rglenn/ottawa-badges-2018/README.md

# ottawa-badges-2018
Maker badges for Maker Faire Ottawa 2018

More information is available on the [wiki](https://github.com/rglenn/ottawa-badges-2018/wiki) - please check there!
