rglenn/ottawa-badges-2018/artwork/maple-leaf.bmp

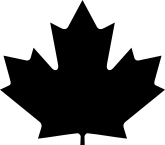
artwork/maple-leaf.bmp
