rglenn/ottawa-badges-2018/Parts for MFOTT badge 2018.docx

# Parts for Maker Faire Ottawa badge 2018

DO NOT MOUNT: C2,C5,R18,R19

0603 Red LED x 41
D1-D41

0603 56 ohm resistor x 10
R1,R2,R3,R4,R5,R6,R7,R9,R10,R16

0603 1K resistor x 4 0603 100n capacitor x 4 0603 220 ohm resistor x 2
R11,R12,R13,R17 C1,C4,C6,C10 R20,R21

0603 10K resistor x 2 0603 1u capacitor x 2 0603 1.5K resistor x 1
R14,R15 C7,C8 R8

0805 10u capacitor x 1 0805 IR LED x 1 MIC5504 voltage regulator x 1
C9 D42 U2

USB connector x 1 ATMega328PB x 1 12 MHz crystal x 1
P1 U1 Y1

Piezo speaker x 1 VS1838B IR receiver x 1
