rglenn/ottawa-badges-2018/pcb/ottawa-badges-2016_bom.xlsx

Source | C:/Projects/ottawa-badges-2016/pcb/ottawa-badges-2016.sch
Kicad Rev | Eeschema 4.0.0-rc1-stable
Generated Date | 2016-11-16 21:01
Title | Not Set
Company | Not Set
Revision | Not Set
Date Issue | Not Set
Reference | Value | Library | Library Ref
U1 | ATMEGA328P-A | BadgeParts | ATMEGA328PB-A
P1 | USB_OTG | conn | USB_OTG
Y1 | 12 MHz | device | Crystal_Small
D3 | Led_Small | device | Led_Small
D4 | Led_Small | device | Led_Small
D5 | Led_Small | device | Led_Small
D6 | Led_Small | device | Led_Small
D2 | Led_Small | device | Led_Small
D1 | Led_Small | device | Led_Small
D9 | Led_Small | device | Led_Small
D10 | Led_Small | device | Led_Small
D11 | Led_Small | device | Led_Small
D12 | Led_Small | device | Led_Small
D8 | Led_Small | device | Led_Small
D7 | Led_Small | device | Led_Small
D15 | Led_Small | device | Led_Small
D16 | Led_Small | device | Led_Small
D17 | Led_Small | device | Led_Small
D18 | Led_Small | device | Led_Small
D14 | Led_Small | device | Led_Small
D13 | Led_Small | device | Led_Small
D21 | Led_Small | device | Led_Small
D22 | Led_Small | device | Led_Small
D23 | Led_Small | device | Led_Small
D24 | Led_Small | device | Led_Small
D20 | Led_Small | device | Led_Small
D19 | Led_Small | device | Led_Small
D27 | Led_Small | device | Led_Small
D28 | Led_Small | device | Led_Small
D29 | Led_Small | device | Led_Small
D30 | Led_Small | device | Led_Small
D26 | Led_Small | device | Led_Small
D25 | Led_Small | device | Led_Small
D33 | Led_Small | device | Led_Small
D34 | Led_Small | device | Led_Small
D35 | Led_Small | device | Led_Small
D36 | Led_Small | device | Led_Small
D32 | Led_Small | device | Led_Small
D31 | Led_Small | device | Led_Small
D39 | Led_Small | device | Led_Small
D40 | Led_Small | device | Led_Small
D38 | Led_Small | device | Led_Small
D37 | Led_Small | device | Led_Small
R1 | 56 | device | R
R2 | 56 | device | R
R3 | 56 | device | R
R4 | 56 | device | R
R5 | 56 | device | R
R6 | 56 | device | R
R7 | 56 | device | R
C5 | 18p | device | C
C2 | 18p | device | C
C4 | 100n | device | C
C6 | 100n | device | C
C1 | 100n | device | C
R10 | 56 | device | R
R9 | 56 | device | R
R8 | 1.5K | device | R
JP1 | Jumper_NC_Small | device | Jumper_NC_Small
JP2 | Jumper_NC_Small | device | Jumper_NC_Small
JP3 | Jumper_NC_Small | device | Jumper_NC_Small
JP4 | Jumper_NC_Small | device | Jumper_NC_Small
JP6 | Jumper_NC_Small | device | Jumper_NC_Small
JP5 | Jumper_NC_Small | device | Jumper_NC_Small
JP7 | Jumper_NC_Small | device | Jumper_NC_Small
U2 | MIC5504-3.3YM5 | regul | LT1761
SW1 | SWITCH_INV | device | SWITCH_INV
C7 | 1u | device | C
C8 | 1u | device | C
BT1 | CR2032 | device | Battery
R12 | 1K | device | R
JP9 | Jumper_NC_Small | device | Jumper_NC_Small
D41 | Led_Small | device | Led_Small
SP1 | SPEAKER | device | SPEAKER
R11 | 1K | device | R
JP8 | Jumper_NC_Small | device | Jumper_NC_Small
R13 | 1K | device | R
JP10 | Jumper_NC_Small | device | Jumper_NC_Small
D42 | Led_Small | device | Led_Small
R14 | 10K | device | R
P4 | CONN_01X10 | conn | CONN_01X10
P5 | CONN_01X08 | conn | CONN_01X08
P2 | CONN_01X08 | conn | CONN_01X08
P3 | CONN_01X06 | conn | CONN_01X06
P6 | CONN_02X03 | conn | CONN_02X03
P7 | CONN_01X01 | conn | CONN_01X01
P8 | CONN_01X01 | conn | CONN_01X01
P10 | CONN_01X01 | conn | CONN_01X01
U3 | VS1838B | BadgeParts | VS1838B
JP11 | Jumper_NC_Small | device | Jumper_NC_Small
R17 | 1K | device | R
R15 | 10K | device | R
C10 | 100n | device | C
R16 | 56 | device | R
C9 | 10u | device | C
P9 | CONN_01X04 | conn | CONN_01X04
