rglenn/ottawa-badges-2018/pcb/ottawa-badges-2016_bom_chipsetter.xlsx

Part | Value | Device | Package | Description
C1 | 100n | C | C_0603
C10 | 100n | C | C_0603
C101 | 100n | C | C_0603
C102 | 18p | C | C_0603
C104 | 100n | C | C_0603
C105 | 18p | C | C_0603
C106 | 100n | C | C_0603
C107 | 1u | C | C_0603
C108 | 1u | C | C_0603
C109 | 10u | C | C_0805
C110 | 100n | C | C_0603
C2 | 18p | C | C_0603
C4 | 100n | C | C_0603
C5 | 18p | C | C_0603
C6 | 100n | C | C_0603
C7 | 1u | C | C_0603
C8 | 1u | C | C_0603
C9 | 10u | C | C_0805
D1 | Led_Small | Led_Small | LED_0603
D10 | Led_Small | Led_Small | LED_0603
D101 | Led_Small | Led_Small | LED_0603
D102 | Led_Small | Led_Small | LED_0603
D103 | Led_Small | Led_Small | LED_0603
D104 | Led_Small | Led_Small | LED_0603
D105 | Led_Small | Led_Small | LED_0603
D106 | Led_Small | Led_Small | LED_0603
D107 | Led_Small | Led_Small | LED_0603
D108 | Led_Small | Led_Small | LED_0603
D109 | Led_Small | Led_Small | LED_0603
D11 | Led_Small | Led_Small | LED_0603
D110 | Led_Small | Led_Small | LED_0603
D111 | Led_Small | Led_Small | LED_0603
D112 | Led_Small | Led_Small | LED_0603
D113 | Led_Small | Led_Small | LED_0603
D114 | Led_Small | Led_Small | LED_0603
D115 | Led_Small | Led_Small | LED_0603
D116 | Led_Small | Led_Small | LED_0603
D117 | Led_Small | Led_Small | LED_0603
D118 | Led_Small | Led_Small | LED_0603
D119 | Led_Small | Led_Small | LED_0603
D12 | Led_Small | Led_Small | LED_0603
D120 | Led_Small | Led_Small | LED_0603
D121 | Led_Small | Led_Small | LED_0603
D122 | Led_Small | Led_Small | LED_0603
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
U1 | ATMEGA328P-A | ATMEGA328PB-A | TQFP-32_7x7mm_Pi
U101 | ATMEGA328P-A | ATMEGA328PB-A | TQFP-32_7x7mm_Pi
U102 | MIC5504-3.3YM5 | LT1761 | SOT-23-5
U2 | MIC5504-3.3YM5 | LT1761 | SOT-23-5
Y1 | 12 MHz | Crystal_Small | crystal_FA238-TS
Y101 | 12 MHz | Crystal_Small | crystal_FA238-TS
