rglenn/ottawa-badges-2018/artwork/makey-floating-pcb-outline.dxf

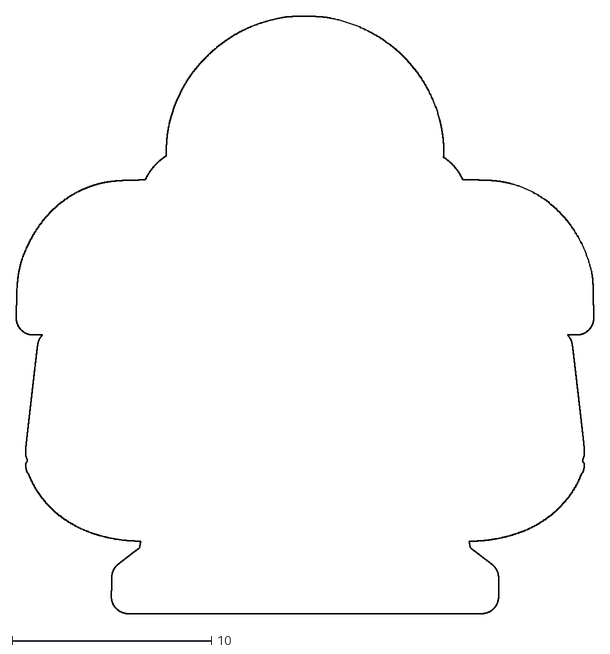
[picture p2: CAD file, 2018-10-16]
artwork/makey-floating-pcb-outline.dxf
29.0 x 30.0
