rglenn/ottawa-badges-2018/artwork/makey-soldering-kit-outline.dxf

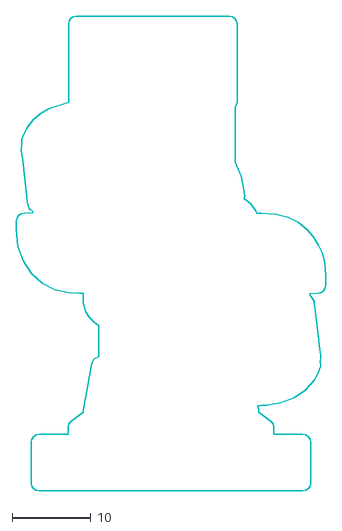
[picture p3: CAD file, 2018-10-16]
artwork/makey-soldering-kit-outline.dxf
39.2 x 60.3
