rglenn/ottawa-badges-2018/artwork/makey-chest-mask.png

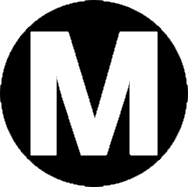
artwork/makey-chest-mask.png
