rglenn/ottawa-badges-2018/artwork/makey-floating-pcb-silk.png

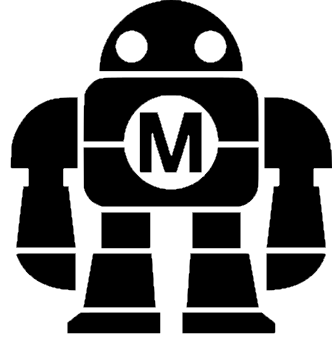
artwork/makey-floating-pcb-silk.png
