rglenn/ottawa-badges-2018/artwork/makey-soldering-kit-silk.png

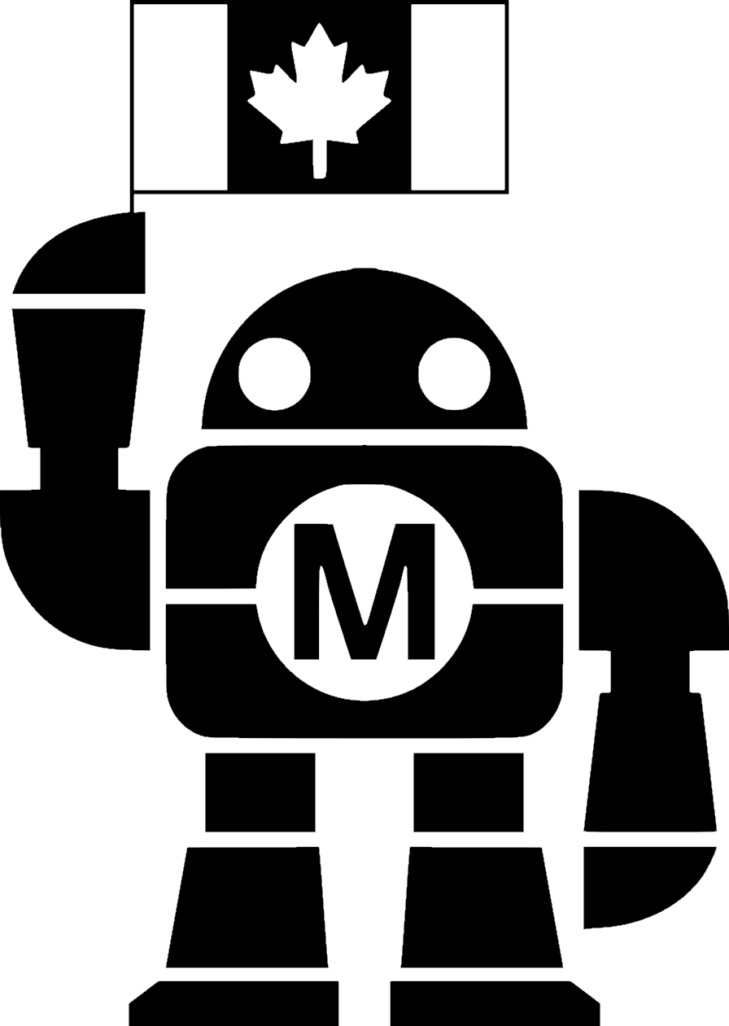
artwork/makey-soldering-kit-silk.png
