rglenn/ottawa-badges-2018/pcb/ottawa-badges-2016.kicad_pcb

## KiCad design pcb/ottawa-badges-2016.kicad_pcb (2018-10-16)

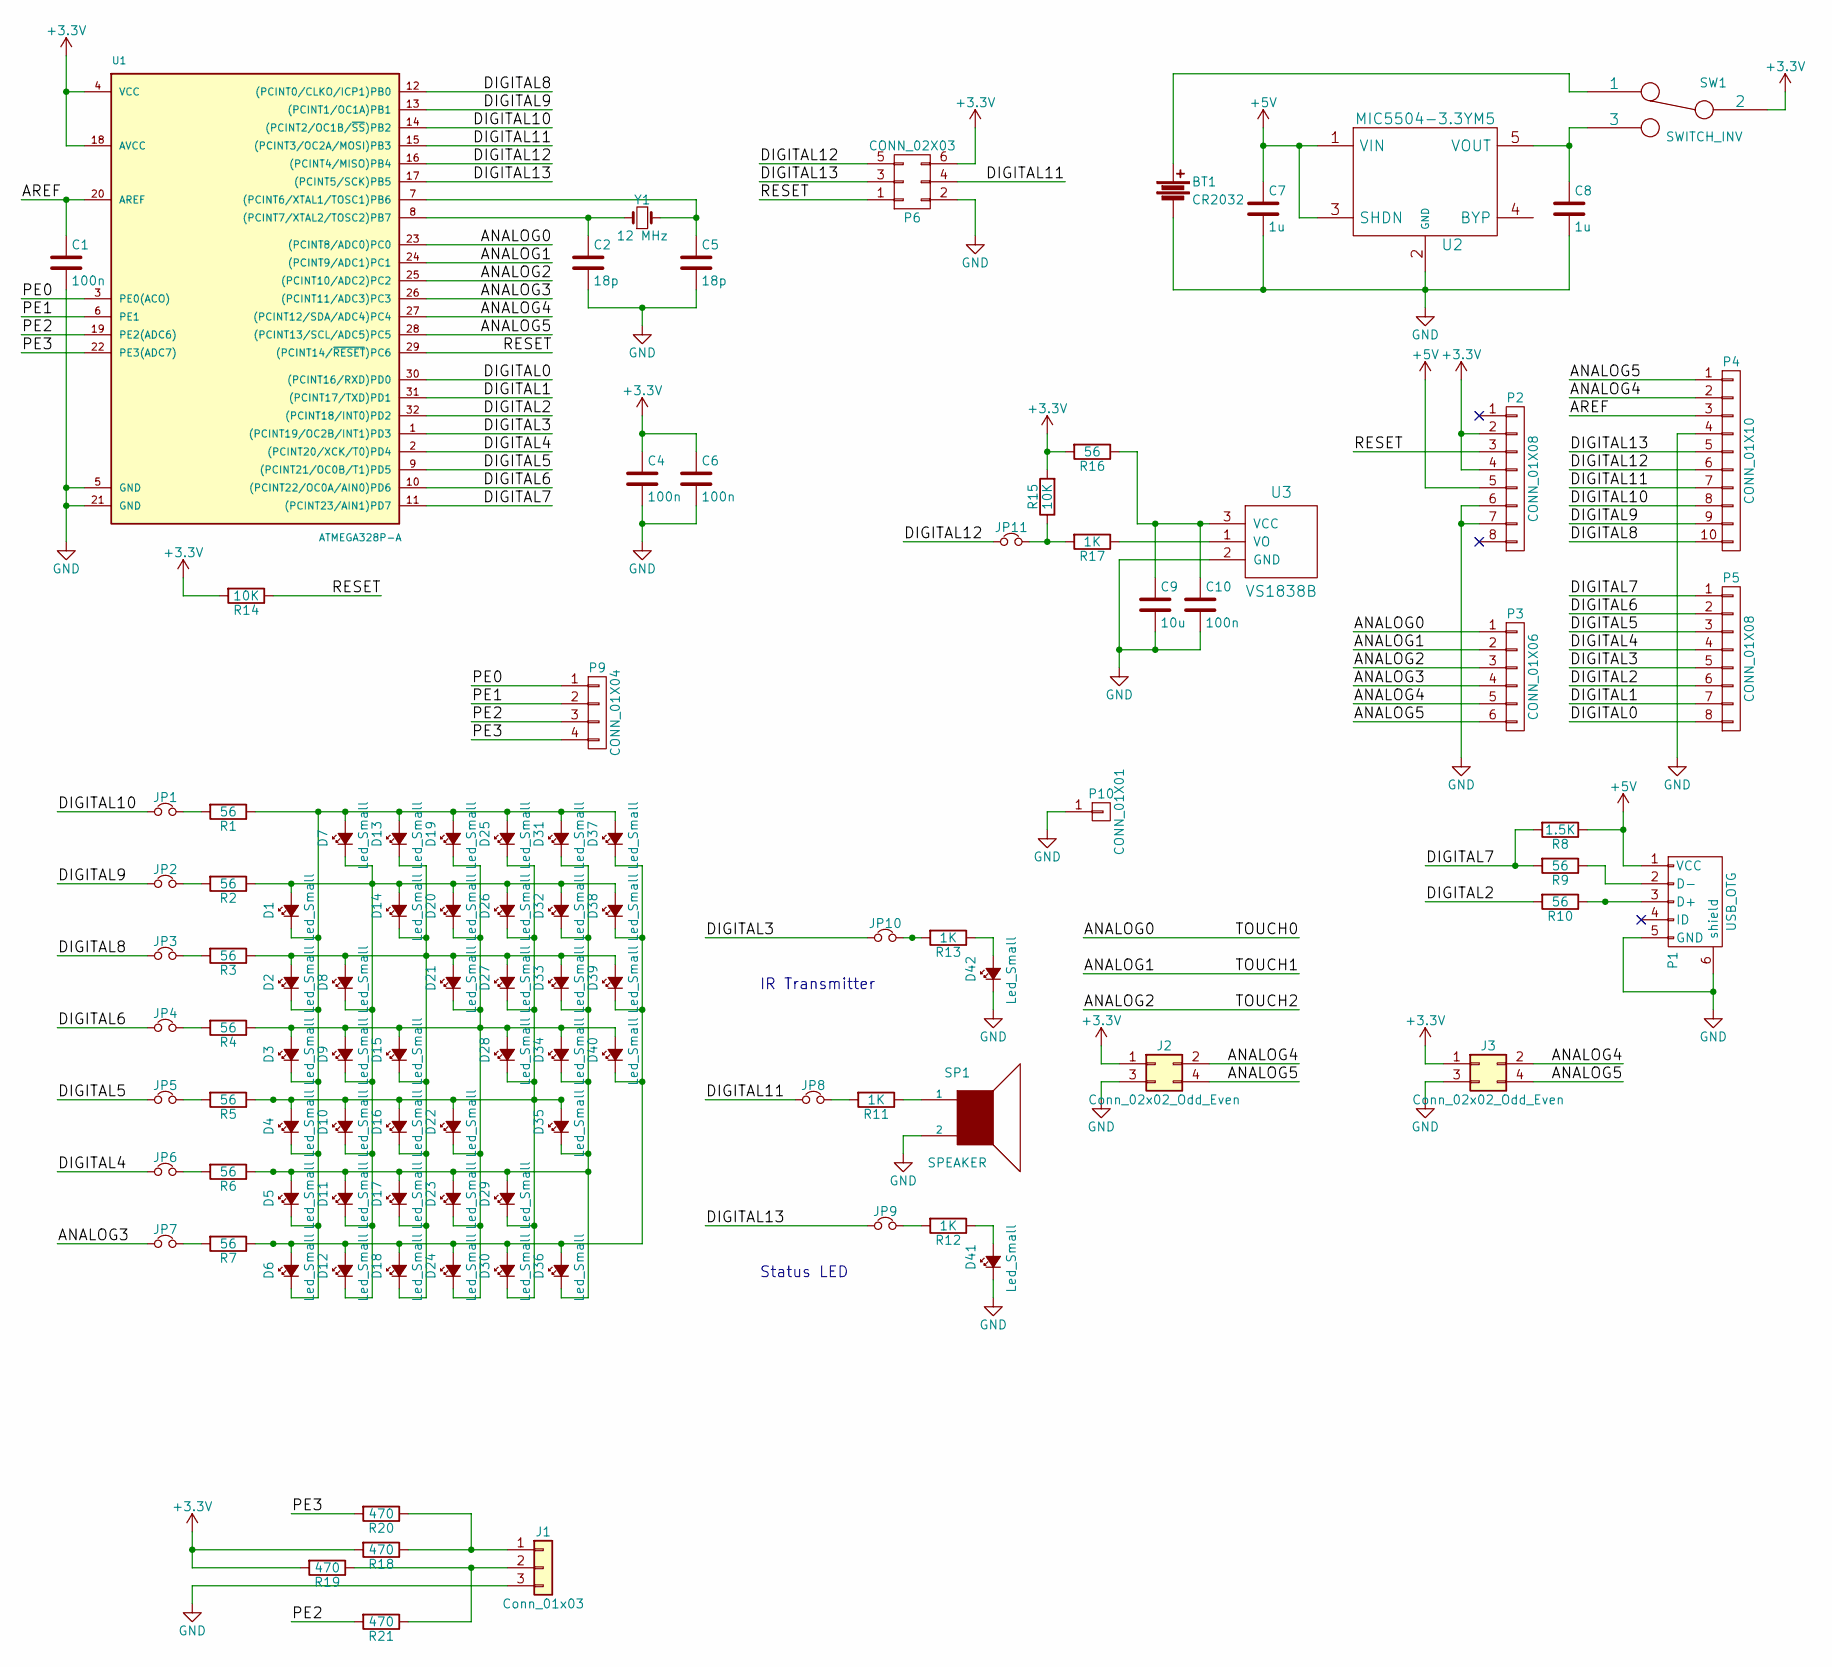
[picture p7: schematic ottawa-badges-2016.sch]

Parts:
BT1: CR2032; CR2032-SHRAPNEL
C1, C4, C6, C10: 100n; C_0603
C2, C5: 18p; C_0603
C7, C8: 1u; C_0603
C9: 10u; C_0805
D1, D2, D3, D4, D5, D6, D7, D8, D9, D10, D11, D12, D13, D14, D15, D16, D17, D18, D19, D20, D21, D22, D23, D24, D25, D26, D27, D28, D29, D30, D31, D32, D33, D34, D35, D36, D37, D38, D39, D40, D41: Led_Small; LED_0603
D42: Led_Small; LED_0805
J1: Conn_01x03; Pin_Header_Straight_1x03_Pitch2.54mm
J2, J3: Conn_02x02_Odd_Even; Pin_Header_Straight_2x02_Pitch2.54mm
JP1, JP2, JP3, JP4, JP5, JP6, JP7, JP8, JP9, JP10, JP11: Jumper_NC_Small; SJ2
P1: USB_OTG; 10118192-0001LF
P2, P5: CONN_01X08; Socket_Strip_Straight_1x08
P3: CONN_01X06; Socket_Strip_Straight_1x06
P4: CONN_01X10; Socket_Strip_Straight_1x10
P6: CONN_02X03; Socket_Strip_Straight_2x03
P9: CONN_01X04; Socket_Strip_Straight_1x04
P10: CONN_01X01; MountingHole_4mm_Pad_Via
R1, R2, R3, R4, R5, R6, R7, R9, R10, R16: 56; R_0603
R8: 1.5K; R_0603
R11, R12, R13, R17: 1K; R_0603
R14, R15: 10K; R_0603
R18, R19, R20, R21: 470; R_0603
SP1: SPEAKER; Buzzer_12x9.5RM7.6
SW1: SWITCH_INV; MK-12C02
U1: ATMEGA328P-A; TQFP-32_7x7mm_Pitch0.8mm
U2: MIC5504-3.3YM5; SOT-23-5
U3: VS1838B; VS1838B-HORIZ
Y1: 12 MHz; crystal_FA238-TSX3225

Connections:
+3V3: C4.1, C6.1, J2.1, J3.1, P2.2, P2.4, P6.6, R14.2, R15.2, R16.2, R18.2, R19.2, SW1.2, U1.4 (VCC), U1.18 (AVCC)
+5V: C7.1, P1.1 (VCC), P2.5, R8.1, U2.1 (VIN), U2.3 (SHDN)
/ANALOG0: P3.1, U1.23 ((PCINT8/ADC0)PC0)
/ANALOG1: P3.2, U1.24 ((PCINT9/ADC1)PC1)
/ANALOG2: P3.3, U1.25 ((PCINT10/ADC2)PC2)
/ANALOG3: JP7.1, P3.4, U1.26 ((PCINT11/ADC3)PC3)
/ANALOG4: J2.2, J3.2, P3.5, P4.2, U1.27 ((PCINT12/SDA/ADC4)PC4)
/ANALOG5: J2.4, J3.4, P3.6, P4.1, U1.28 ((PCINT13/SCL/ADC5)PC5)
/AREF: C1.1, P4.3, U1.20 (AREF)
/DIGITAL0: P5.8, U1.30 ((PCINT16/RXD)PD0)
/DIGITAL1: P5.7, U1.31 ((PCINT17/TXD)PD1)
/DIGITAL2: P5.6, R10.2, U1.32 ((PCINT18/INT0)PD2)
/DIGITAL3: JP10.1, P5.5, U1.1 ((PCINT19/OC2B/INT1)PD3)
/DIGITAL4: JP6.1, P5.4, U1.2 ((PCINT20/XCK/T0)PD4)
/DIGITAL5: JP5.1, P5.3, U1.9 ((PCINT21/OC0B/T1)PD5)
/DIGITAL6: JP4.1, P5.2, U1.10 ((PCINT22/OC0A/AIN0)PD6)
/DIGITAL7: P5.1, R8.2, R9.2, U1.11 ((PCINT23/AIN1)PD7)
/DIGITAL8: JP3.1, P4.10, U1.12 ((PCINT0/CLKO/ICP1)PB0)
/DIGITAL9: JP2.1, P4.9, U1.13 ((PCINT1/OC1A)PB1)
/DIGITAL10: JP1.1, P4.8, U1.14 ((PCINT2/OC1B/~SS~)PB2)
/DIGITAL11: JP8.1, P4.7, P6.4, U1.15 ((PCINT3/OC2A/MOSI)PB3)
/DIGITAL12: JP11.1, P4.6, P6.5, U1.16 ((PCINT4/MISO)PB4)
/DIGITAL13: JP9.1, P4.5, P6.3, U1.17 ((PCINT5/SCK)PB5)
/PE0: P9.1, U1.3 (PE0(ACO))
/PE1: P9.2, U1.6 (PE1)
/PE2: P9.3, R21.2, U1.19 (PE2(ADC6))
/PE3: P9.4, R20.2, U1.22 (PE3(ADC7))
/RESET: P2.3, P6.1, R14.1, U1.29 ((PCINT14/~RESET~)PC6)
GND: BT1.2, C1.2, C2.2, C4.2, C5.2, C6.2, C7.2, C8.2, C9.2, C10.2, D41.1 (K), D42.1 (K), J1.3, J2.3, J3.3, P1.5 (GND), P1.6 (shield), P2.6, P2.7, P4.4, P6.2, P10.1, SP1.2, U1.5 (GND), U1.21 (GND), U2.2 (GND), U3.2 (GND)
unnamed: BT1.1, SW1.1
unnamed: C2.1, U1.8 ((PCINT7/XTAL2/TOSC2)PB7), Y1.1
unnamed: C5.1, U1.7 ((PCINT6/XTAL1/TOSC1)PB6), Y1.2
unnamed: C8.1, SW1.3, U2.5 (VOUT)
unnamed: C9.1, C10.1, R16.1, U3.3 (VCC)
unnamed: D1.1 (K), D2.1 (K), D3.1 (K), D4.1 (K), D5.1 (K), D6.1 (K), D7.2 (A), D13.2 (A), D19.2 (A), D25.2 (A), D31.2 (A), D37.2 (A), R1.1
unnamed: D1.2 (A), D7.1 (K), D8.1 (K), D9.1 (K), D10.1 (K), D11.1 (K), D12.1 (K), D14.2 (A), D20.2 (A), D26.2 (A), D32.2 (A), D38.2 (A), R2.1
unnamed: D4.2 (A), D10.2 (A), D16.2 (A), D22.2 (A), D25.1 (K), D26.1 (K), D27.1 (K), D28.1 (K), D29.1 (K), D30.1 (K), D35.2 (A), R5.1
unnamed: D5.2 (A), D11.2 (A), D17.2 (A), D23.2 (A), D29.2 (A), D31.1 (K), D32.1 (K), D33.1 (K), D34.1 (K), D35.1 (K), D36.1 (K), R6.1
unnamed: D6.2 (A), D12.2 (A), D18.2 (A), D24.2 (A), D30.2 (A), D36.2 (A), D37.1 (K), D38.1 (K), D39.1 (K), D40.1 (K), R7.1
unnamed: D2.2 (A), D8.2 (A), D13.1 (K), D14.1 (K), D15.1 (K), D16.1 (K), D17.1 (K), D18.1 (K), D21.2 (A), D27.2 (A), D33.2 (A), D39.2 (A), R3.1
unnamed: D3.2 (A), D9.2 (A), D15.2 (A), D19.1 (K), D20.1 (K), D21.1 (K), D22.1 (K), D23.1 (K), D24.1 (K), D28.2 (A), D34.2 (A), D40.2 (A), R4.1
unnamed: D41.2 (A), R12.1
unnamed: D42.2 (A), R13.1
unnamed: J1.1, R18.1, R20.1
unnamed: J1.2, R19.1, R21.1
unnamed: JP1.2, R1.2
unnamed: JP2.2, R2.2
unnamed: JP3.2, R3.2
unnamed: JP4.2, R4.2
unnamed: JP5.2, R5.2
unnamed: JP6.2, R6.2
unnamed: JP7.2, R7.2
unnamed: JP8.2, R11.2
unnamed: JP9.2, R12.2
unnamed: JP10.2, R13.2
unnamed: JP11.2, R15.1, R17.2
unnamed: P1.2 (D-), R9.1
unnamed: P1.3 (D+), R10.1
unnamed: R11.1, SP1.1
unnamed: R17.1, U3.1 (VO)

Notes on the sheet:
IR Transmitter
Status LED

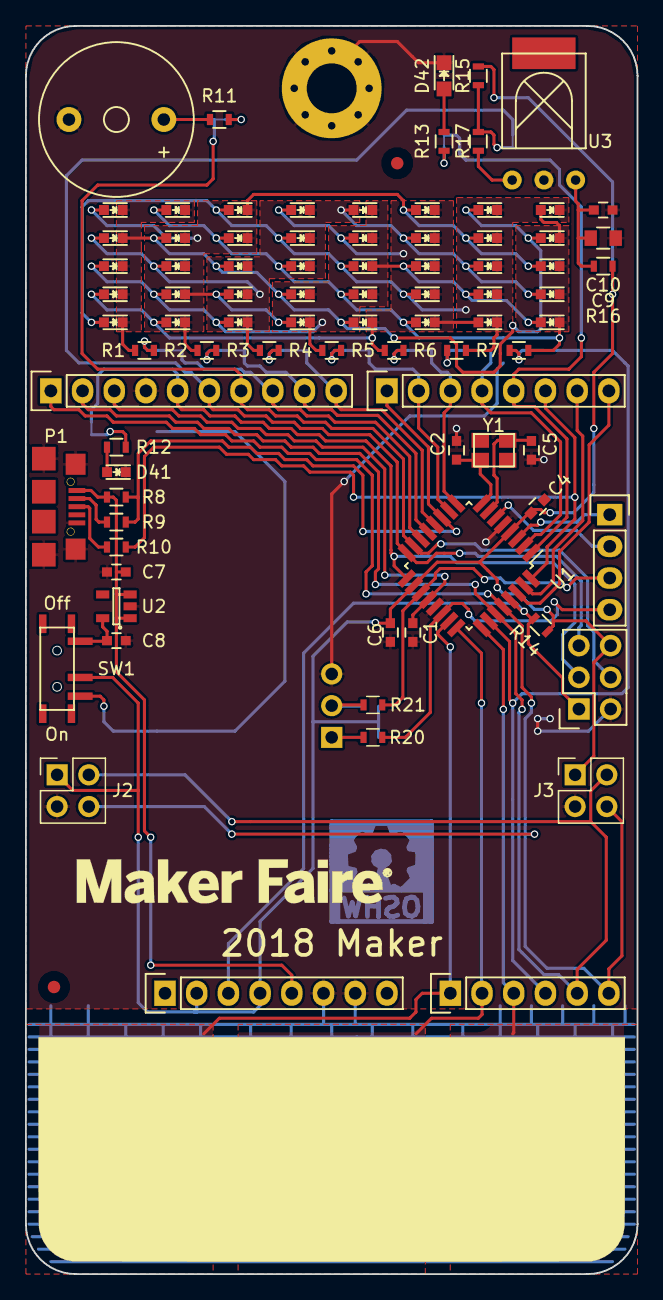
[picture p8: board ottawa-badges-2016.kicad_pcb from above]

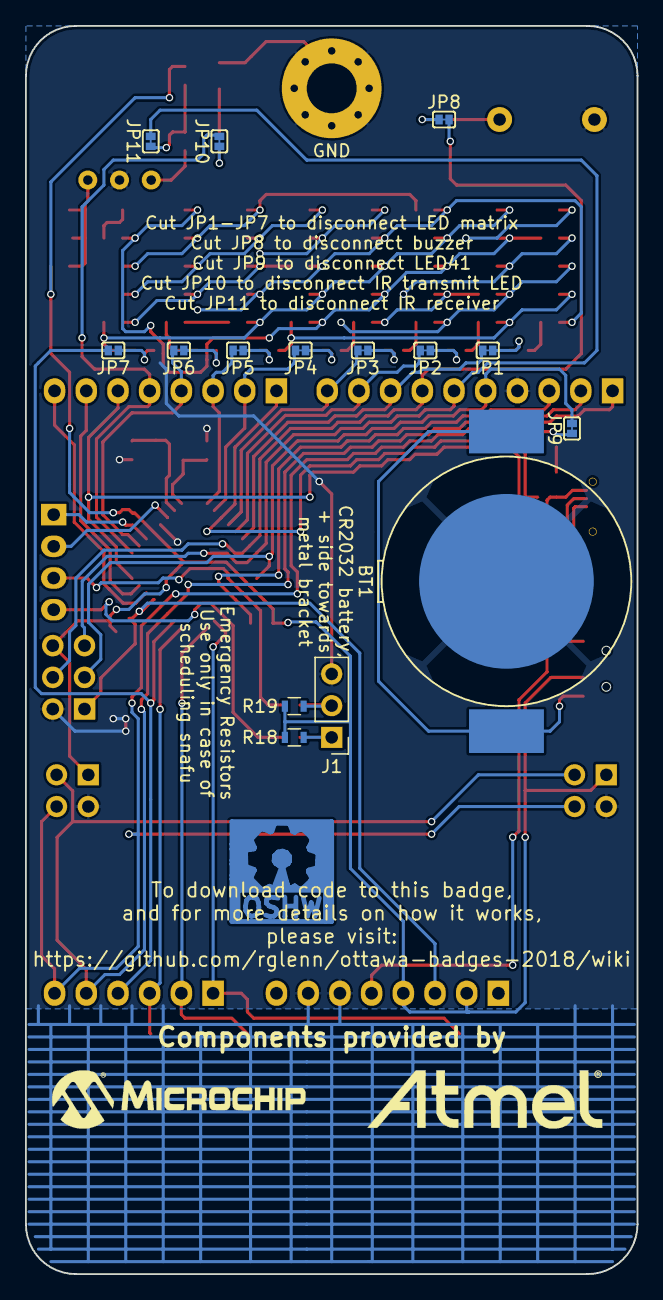
[picture p9: board ottawa-badges-2016.kicad_pcb from below]

Board: 2 copper layers, 49.0 x 100.0 mm, 101 parts (15 on the bottom side), 60 nets.
