rglenn/ottawa-badges-2018/soldering-pcb/soldering-pcb.kicad_pcb

## KiCad design soldering-pcb/soldering-pcb.kicad_pcb (2018-10-16)

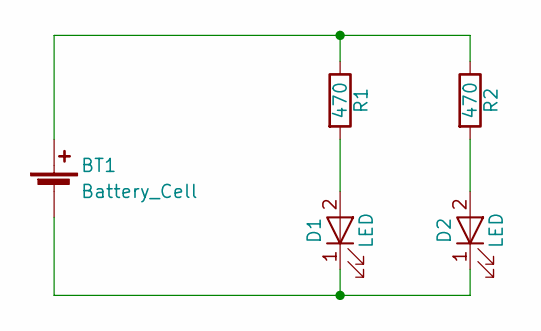
[picture p10: schematic soldering-pcb.sch]

Parts:
BT1: Battery_Cell; CR2032-SHRAPNEL
D1, D2: LED; LED_D5.0mm
R1, R2: 470; R_Axial_DIN0204_L3.6mm_D1.6mm_P7.62mm_Horizontal

Connections:
unnamed: BT1.1 (+), R1.1, R2.1
unnamed: BT1.2 (-), D1.1 (K), D2.1 (K)
unnamed: D1.2 (A), R1.2
unnamed: D2.2 (A), R2.2

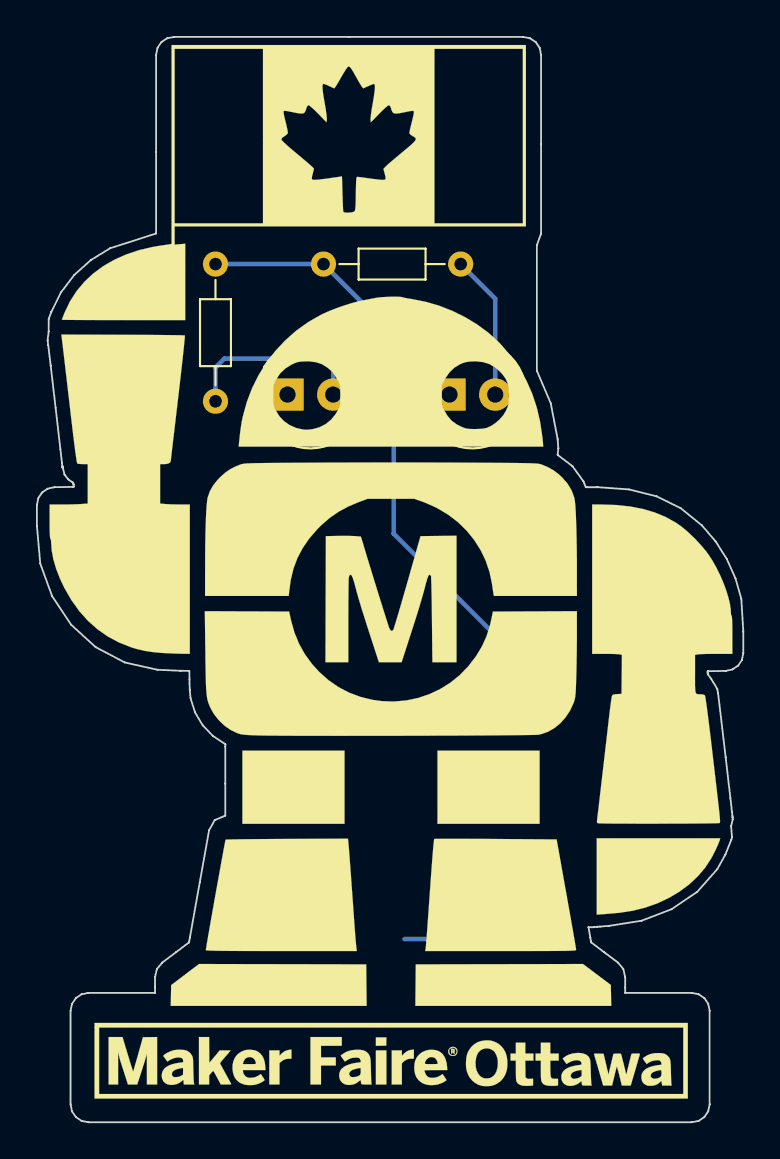
[picture p11: board soldering-pcb.kicad_pcb from above]

Board: 2 copper layers, 39.2 x 60.3 mm, 5 parts (1 on the bottom side), 4 nets.
