rglenn/ottawa-badges-2018/floating-pcb/makey-floating-pcb.kicad_pcb

## KiCad design floating-pcb/makey-floating-pcb.kicad_pcb (2018-10-16)

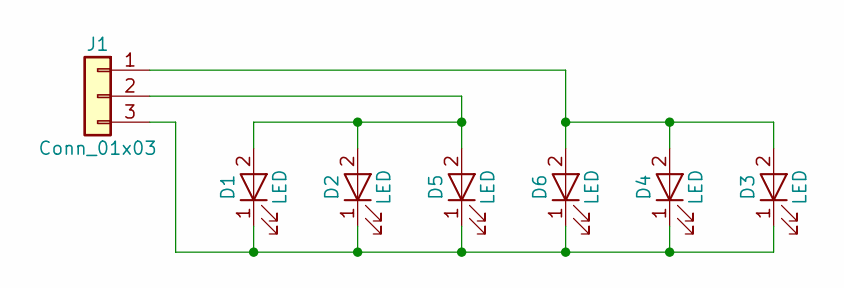
[picture p12: schematic makey-floating-pcb.sch]

Parts:
D1, D2, D3, D4: LED; LED_0603
D5, D6: LED; LED_D3.0mm_Horizontal_O1.27mm_Z2.0mm
J1: Conn_01x03; Pin_Header_Straight_1x03_Pitch2.54mm

Connections:
unnamed: D1.1 (K), D2.1 (K), D3.1 (K), D4.1 (K), D5.1 (K), D6.1 (K), J1.3
unnamed: D1.2 (A), D2.2 (A), D5.2 (A), J1.2
unnamed: D3.2 (A), D4.2 (A), D6.2 (A), J1.1

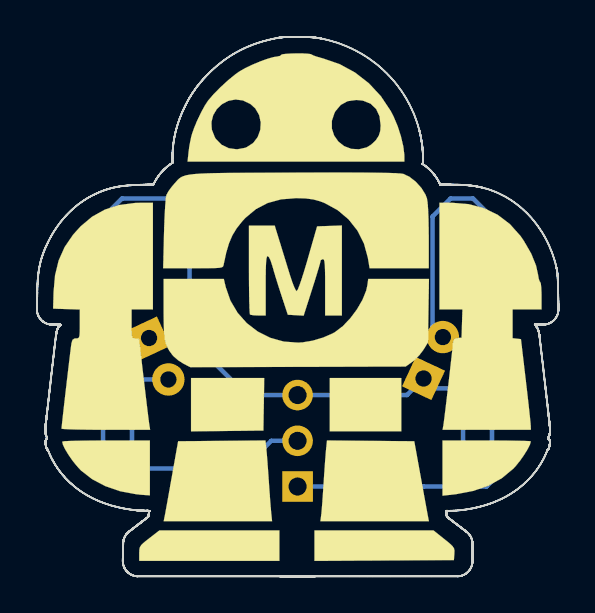
[picture p13: board makey-floating-pcb.kicad_pcb from above]

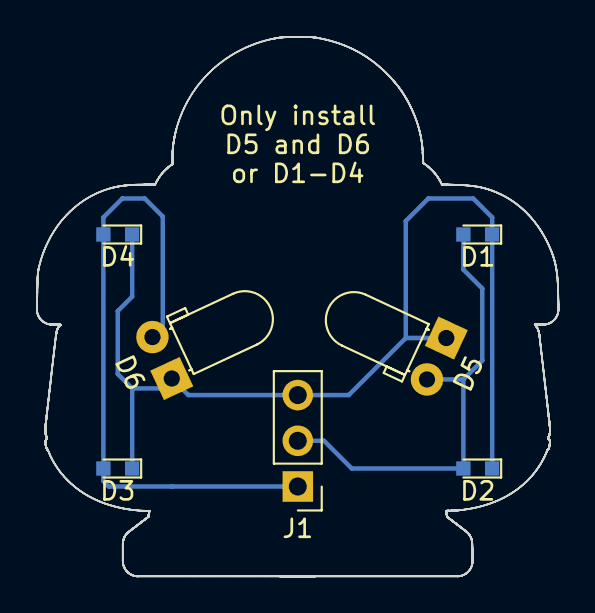
[picture p14: board makey-floating-pcb.kicad_pcb from below]

Board: 2 copper layers, 29.0 x 30.0 mm, 7 parts (7 on the bottom side), 3 nets.
