rglenn/ottawa-badges-2018/code/OttawaBadgeCode2018/animations.h

#pragma once

#include "Arduino.h"

const PROGMEM animationFrame ledWipeDown[] = { 
  {{0xFF, 0x00, 0x00, 0x00, 0x00}, 100}, 
  {{0x00, 0xFF, 0x00, 0x00, 0x00}, 100}, 
  {{0x00, 0x00, 0xFF, 0x00, 0x00}, 100}, 
  {{0x00, 0x00, 0x00, 0xFF, 0x00}, 100}, 
  {{0x00, 0x00, 0x00, 0x00, 0xFF}, 100},
  {{0x00, 0x00, 0x00, 0x00, 0x00}, 100}
}; // 6 frames

const PROGMEM animationFrame ledWipeUp[] = { 
  {{0x00, 0x00, 0x00, 0x00, 0xFF}, 100},
  {{0x00, 0x00, 0x00, 0xFF, 0x00}, 100},
  {{0x00, 0x00, 0xFF, 0x00, 0x00}, 100}, 
  {{0x00, 0xFF, 0x00, 0x00, 0x00}, 100}, 
  {{0xFF, 0x00, 0x00, 0x00, 0x00}, 100},
  {{0x00, 0x00, 0x00, 0x00, 0x00}, 100}
}; // 6 frames

const PROGMEM animationFrame ledWipeLeft[] = { 
  {{0x80, 0x80, 0x80, 0x80, 0x80}, 200},
  {{0xC0, 0xC0, 0xC0, 0xC0, 0xC0}, 200}, 
  {{0x60, 0x60, 0x60, 0x60, 0x60}, 200}, 
  {{0x30, 0x30, 0x30, 0x30, 0x30}, 200}, 
  {{0x18, 0x18, 0x18, 0x18, 0x18}, 200}, 
  {{0x0C, 0x0C, 0x0C, 0x0C, 0x0C}, 200}, 
  {{0x06, 0x06, 0x06, 0x06, 0x06}, 200}, 
  {{0x03, 0x03, 0x03, 0x03, 0x03}, 200}, 
  {{0x01, 0x01, 0x01, 0x01, 0x01}, 200}, 

}; // 9 frames
const PROGMEM animationFrame ledWipeRight[] = { 
  {{0x01, 0x01, 0x01, 0x01, 0x01}, 200}, 
  {{0x03, 0x03, 0x03, 0x03, 0x03}, 200}, 
  {{0x06, 0x06, 0x06, 0x06, 0x06}, 200}, 
  {{0x0C, 0x0C, 0x0C, 0x0C, 0x0C}, 200}, 
  {{0x18, 0x18, 0x18, 0x18, 0x18}, 200}, 
  {{0x30, 0x30, 0x30, 0x30, 0x30}, 200}, 
  {{0x60, 0x60, 0x60, 0x60, 0x60}, 200}, 
  {{0xC0, 0xC0, 0xC0, 0xC0, 0xC0}, 200}, 
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
  {{0xFF, 0x00, 0x00, 0x00, 0x00}, 200}, 
  {{0xFF, 0xFF, 0x00, 0x00, 0x00}, 200}, 
  {{0xFF, 0xFF, 0xFF, 0x00, 0x00}, 200}, 
  {{0xFF, 0xFF, 0xFF, 0xFF, 0x00}, 200}, 
  {{0xFF, 0xFF, 0xFF, 0xFF, 0xFF}, 200}, 
}; // 5 frames

#define EXISTING_MAKER_ANIM_LENGTH 5
