rglenn/ottawa-badges-2018/code/OttawaBadgeCode2018/infrared.cpp

/*
    This file is part of OttawaBadges2015.

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
    You should have received a copy of the GNU General Public License
    along with Foobar.  If not, see <http://www.gnu.org/licenses/>.
*/

#include "Arduino.h"
#include "infrared.h"
#include <IRremote.h>
#include "crc4.h"

IRrecv irrecv(IR_IN_PIN);
IRsend irsend;

void infrared_enable() {
  irrecv.enableIRIn();
}

void infrared_sendRaw(uint32_t packet) {
  //DEBUG_PRINTLN(packet, BIN);
  irsend.sendSony(packet, 20);
  delay(15);
  irrecv.enableIRIn();
}

irReturn infrared_checkPacket(uint32_t *packet) {
  decode_results results;
  
  if(!irrecv.decode(&results)) {
    return IR_NONE;
  }
  
  // first check that the packet was a Sony format
  if(results.decode_type != SONY) {
    irrecv.resume();
    return IR_BAD_FORMAT;
  }

  // next check number of bits
  if(results.bits != 20) {
    irrecv.resume();
    return IR_BAD_LENGTH;
  }

  // next check CRC
  *packet = results.value;
  if(!crc4_checkChecksum(*packet)) {
    irrecv.resume();
    return IR_BAD_CRC;
  }

  // now check command type


  irrecv.resume();

  // ok if it passes
  return IR_OK;  
}

uint32_t infrared_buildPacket(irType packetType, uint16_t irPayload) {
  uint32_t scratch = 0;
  uint8_t crcVal;

  scratch = ((uint32_t)(packetType & 0x0F)) << 16UL;
  scratch |= (irPayload & 0x0FFF) << 4;
  crcVal = crc4_getChecksum(scratch);
  scratch |= (crcVal & 0x0F);
  return scratch;
}

void infrared_sendIdentifyCommand() {
  uint32_t packet;

  packet = infrared_buildPacket(IR_TYPE_IDENTIFY, 0);
  infrared_sendRaw(packet);
}

void infrared_sendIdentifyResponse(uint8_t boardType, uint8_t verMajor, uint8_t verMinor) {
  uint16_t payload = 0;
  uint32_t packet;
  
  payload |= (boardType & 0x0F) << 8;
  payload |= (verMajor & 0x0F) << 4;
  payload |= (verMinor & 0x0F);

  packet = infrared_buildPacket(IR_TYPE_IDENTIFY_RESPONSE, payload);
  infrared_sendRaw(packet);
}

void infrared_sendSetNumMakersCommand(uint16_t numMakers) {
  uint16_t payload = 0;
  uint32_t packet;

  payload |= (numMakers & 0x0FFF);

  packet = infrared_buildPacket(IR_TYPE_SET_NUM_MAKERS, payload);
  infrared_sendRaw(packet);
}

void infrared_sendSetNumMakersResponse(uint16_t numMakers) {
  uint16_t payload = 0;
  uint32_t packet;

  payload |= (numMakers & 0x0FFF);

  packet = infrared_buildPacket(IR_TYPE_SET_NUM_MAKERS_RESPONSE, payload);
  infrared_sendRaw(packet);
}

void infrared_sendListMakersCommand() {
  uint16_t payload = 0;
  uint32_t packet = 0;

  packet = infrared_buildPacket(IR_TYPE_LIST_MAKERS, payload);
  infrared_sendRaw(packet);
}

void infrared_sendListMakersResponse(uint16_t makerID) {
  uint16_t payload = 0;
  uint32_t packet;

  payload |= (makerID & 0x0FFF);

  packet = infrared_buildPacket(IR_TYPE_LIST_MAKERS_RESPONSE, payload);
  infrared_sendRaw(packet);
}

void infrared_sendPlayAnimationCommand(uint8_t animationNum, uint8_t timeoutVal) {
  uint16_t payload = 0;
  uint32_t packet;

  payload |= (animationNum & 0x0F) << 8;
  payload |= timeoutVal;

  packet = infrared_buildPacket(IR_TYPE_PLAY_ANIMATION, payload);
  infrared_sendRaw(packet);
}

void infrared_sendBeacon(uint16_t idVal) {
  uint16_t payload = 0;
  uint32_t packet;

  payload |= (idVal & 0x0FFF);
  packet = infrared_buildPacket(IR_TYPE_BEACON, payload);
  infrared_sendRaw(packet);
}

void infrared_sendResetCommand() {
  uint16_t payload = 0;
  uint32_t packet = 0;

  packet = infrared_buildPacket(IR_TYPE_RESET, payload);
  infrared_sendRaw(packet);
}

decodedPacket infrared_decodePacket(uint32_t packet) {
  decodedPacket scratch;

  scratch.type = (irType)((packet & 0x000F0000UL) >> 16);
  
  switch(scratch.type) {
    case IR_TYPE_IDENTIFY:
    case IR_TYPE_LIST_MAKERS:
    case IR_TYPE_RESET:
    default:
      scratch.param1 = 0;
      scratch.param2 = 0;
      scratch.param3 = 0;
      break;
    case IR_TYPE_IDENTIFY_RESPONSE:
      scratch.param1 = ((packet & 0x0000F000UL) >> 12); // board type
      scratch.param2 = ((packet & 0x00000F00UL) >> 8); // major ver
      scratch.param3 = ((packet & 0x000000F0UL) >> 4); // minor ver
      break;
    case IR_TYPE_SET_NUM_MAKERS:
    case IR_TYPE_SET_NUM_MAKERS_RESPONSE:
    case IR_TYPE_BEACON:
      scratch.param1 = (packet & 0x0000FFF0UL) >> 4; // Actual ID value
      scratch.param2 = 0; 
      scratch.param3 = 0;
      break;
    case IR_TYPE_LIST_MAKERS_RESPONSE:
      scratch.param1 = (packet & 0x0000FFF0UL) >> 4; // Actual ID value
      scratch.param2 = 0;
      scratch.param3 = 0;
      break;
    case IR_TYPE_PLAY_ANIMATION:
      scratch.param1 = (packet & 0x0000F000UL) >> 12; // Animation number
      scratch.param2 = (packet & 0x00000FF0UL) >> 4; // Animation duration
      scratch.param3 = 0;
      break;
  }
  
  return scratch;
}
