rglenn/ottawa-badges-2018/(commit log)

2018-05-19 Initial import from 2016 files
    [ottawa-badges-2016-B_Cu.gbl, ottawa-badges-2016-B_Mask.gbs, ottawa-badges-2016-B_SilkS.gbo, ottawa-badges-2016-F_Cu.gtl, ottawa-badges-2016-F_Mask.gts, ottawa-badges-2016-F_Paste.gtp, ottawa-badges-2016-F_SilkS.gto, ottawa-badges-2016-maker-panel-B_Cu.gbl]
2018-10-16 Adding all latest files.
    [makey-floating-pcb-B.Cu.gbl, makey-floating-pcb-B.Mask.gbs, makey-floating-pcb-B.SilkS.gbo, makey-floating-pcb-Edge.Cuts.gm1, makey-floating-pcb-F.Cu.gtl, makey-floating-pcb-F.Mask.gts, makey-floating-pcb-F.Paste.gtp, makey-floating-pcb-F.SilkS.gto]
