rglenn/ottawa-badges-2018/(notices)

Notices in the files:
code/OttawaBadgeCode2018/animation.cpp:
OttawaBadges2016 is free software: you can redistribute it and/or modify
it under the terms of the GNU General Public License as published by
the Free Software Foundation, either version 3 of the License, or
(at your option) any later version.
